armgord/Exocortex/hardware/m1_discrete_afe.kicad_sch

## KiCad design hardware/m1_discrete_afe.kicad_sch (2026-11-02)

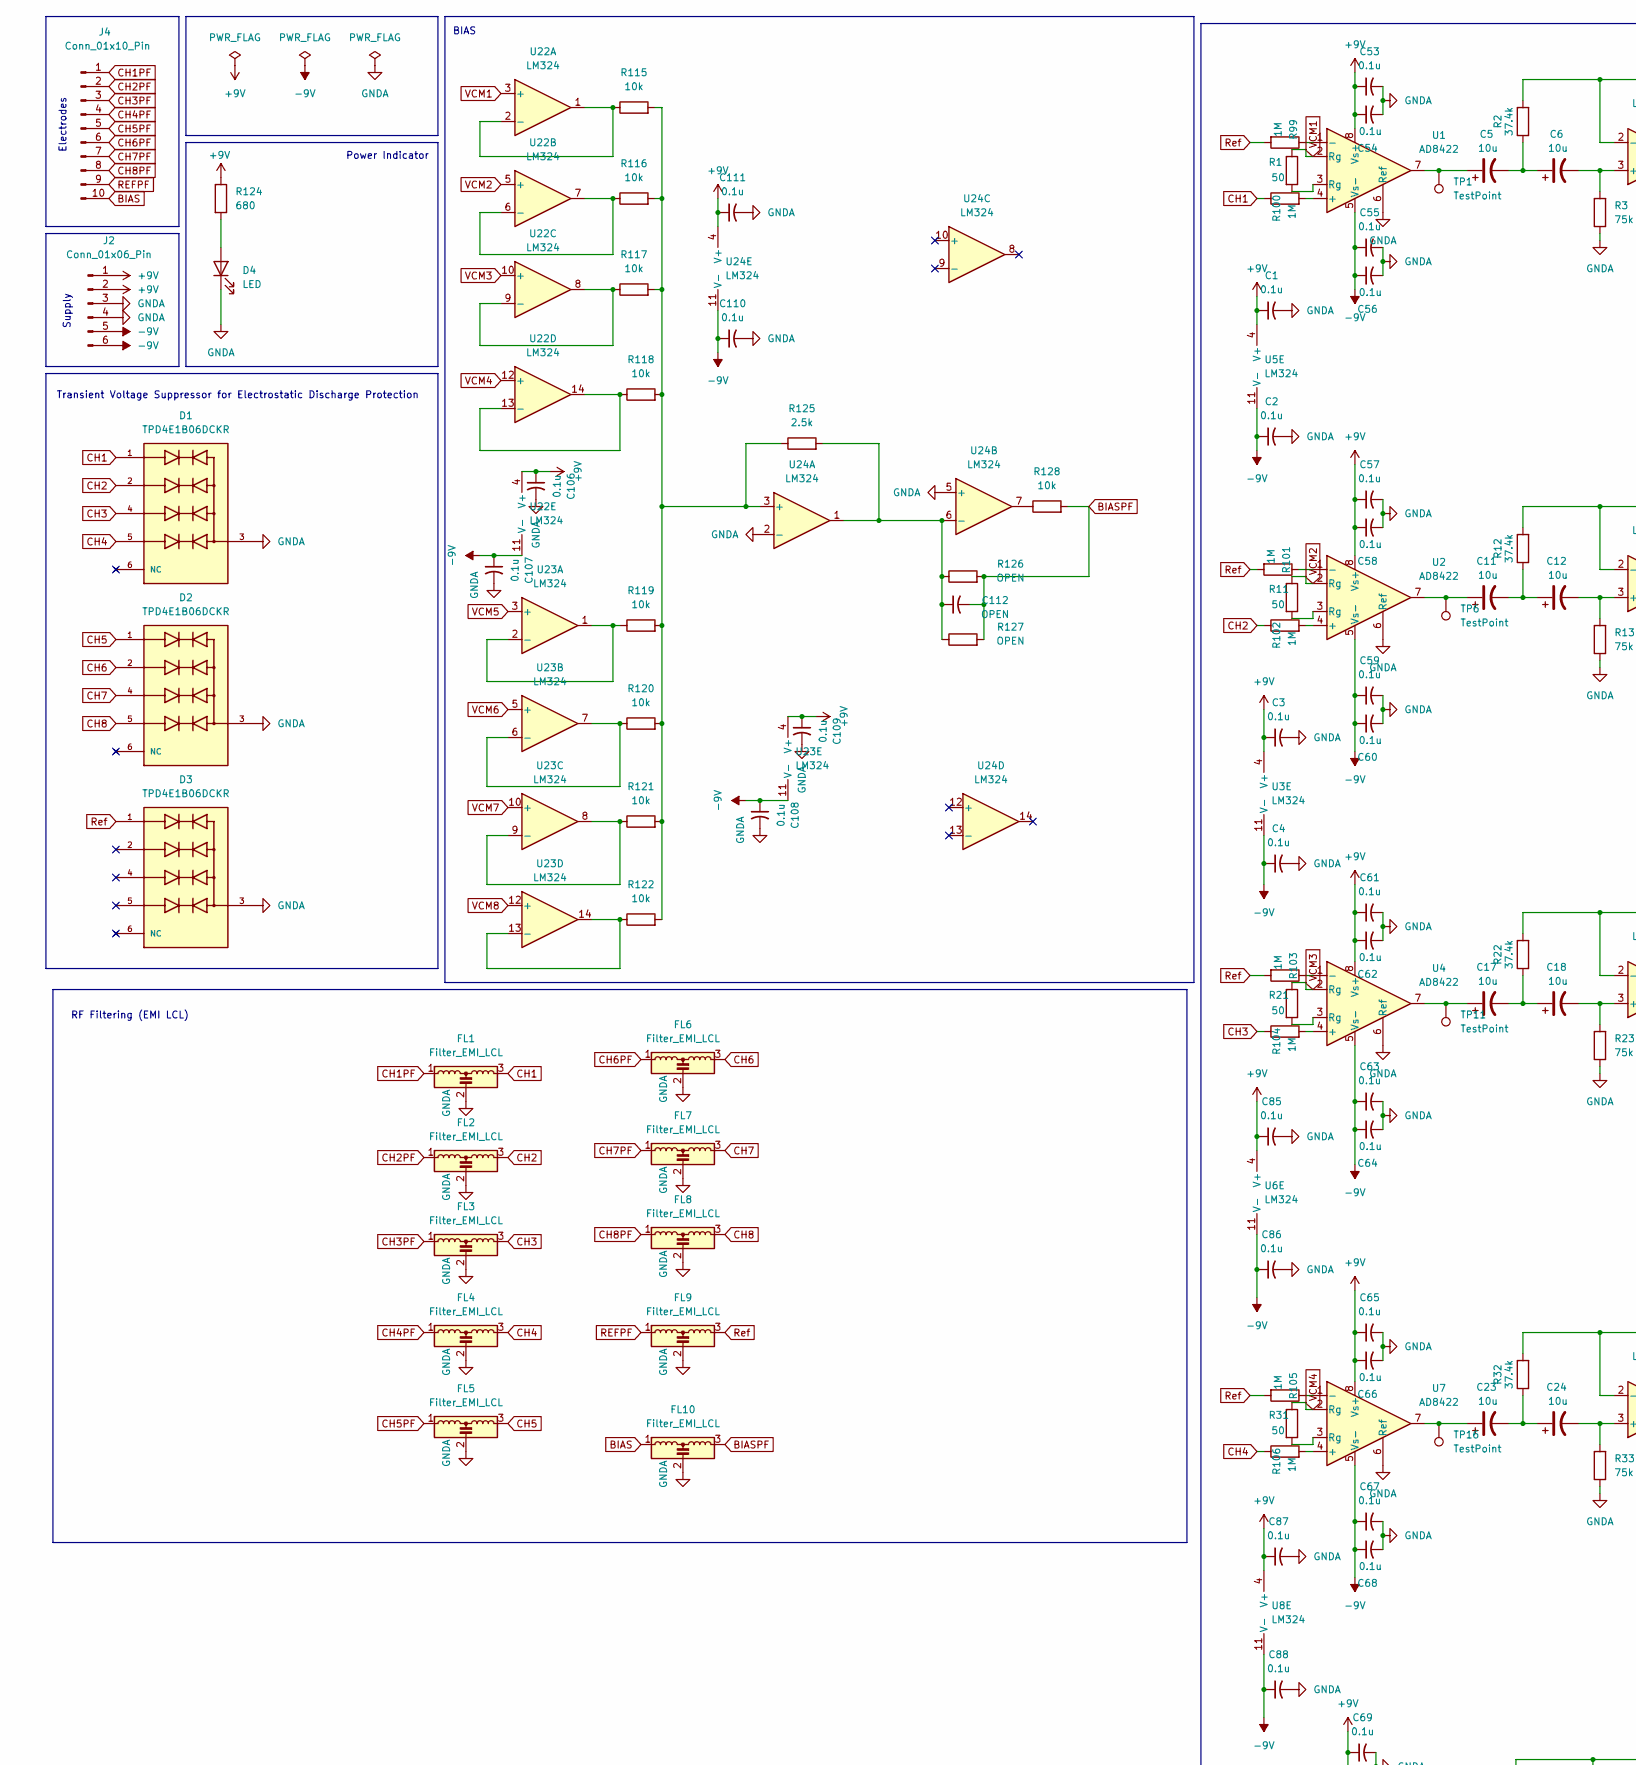
[picture p4: schematic m1_discrete_afe.kicad_sch, part in row 1, column 1]

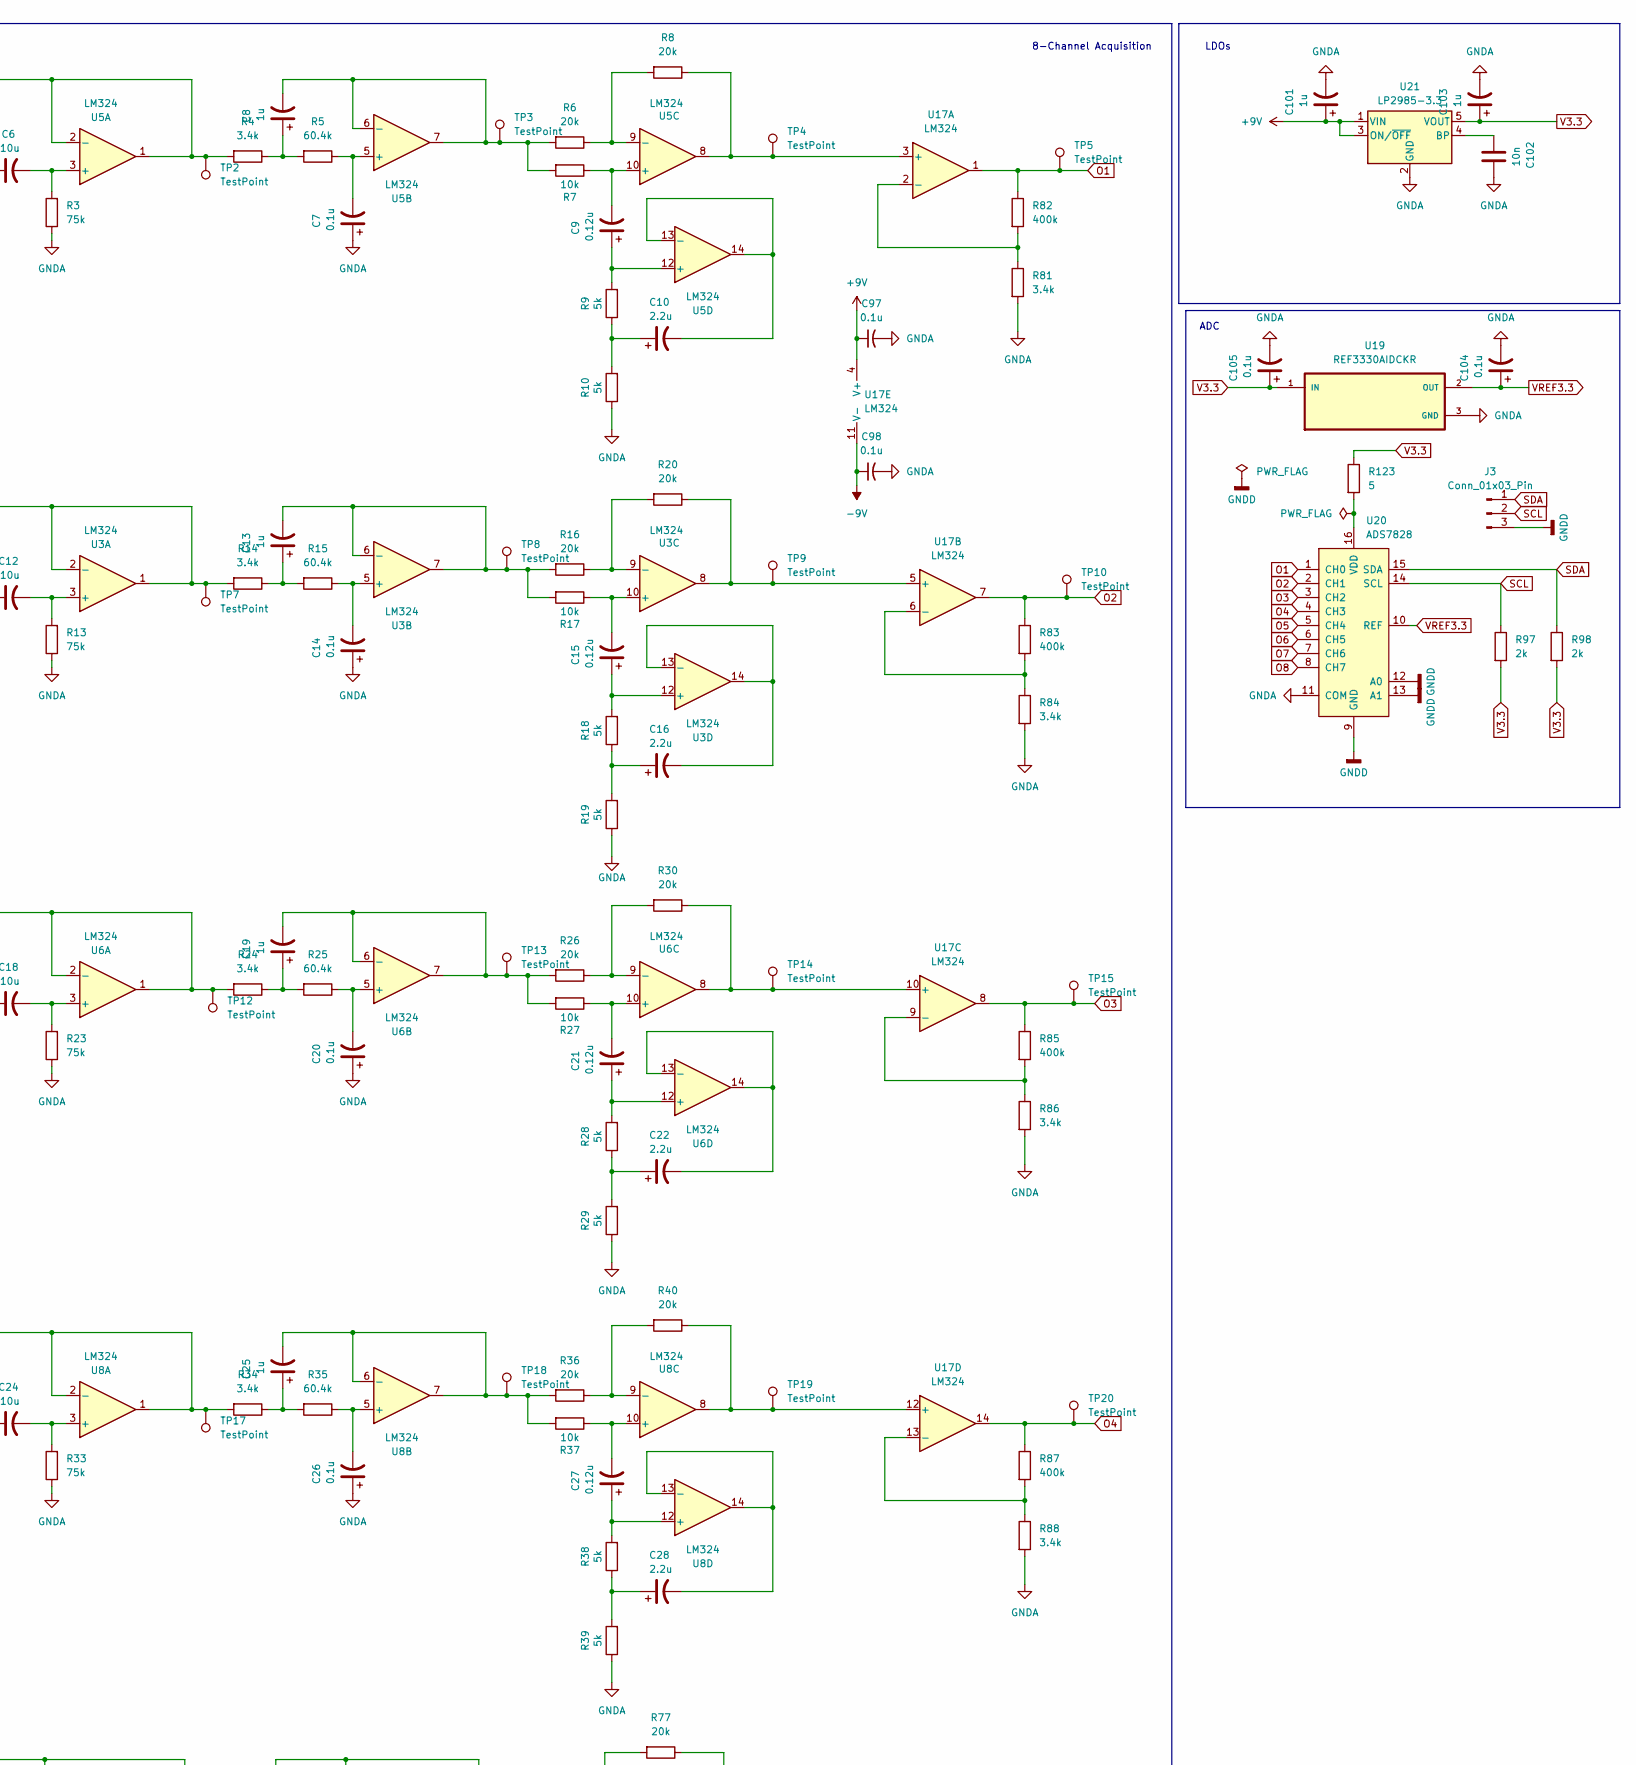
[picture p5: schematic m1_discrete_afe.kicad_sch, part in row 1, column 2]

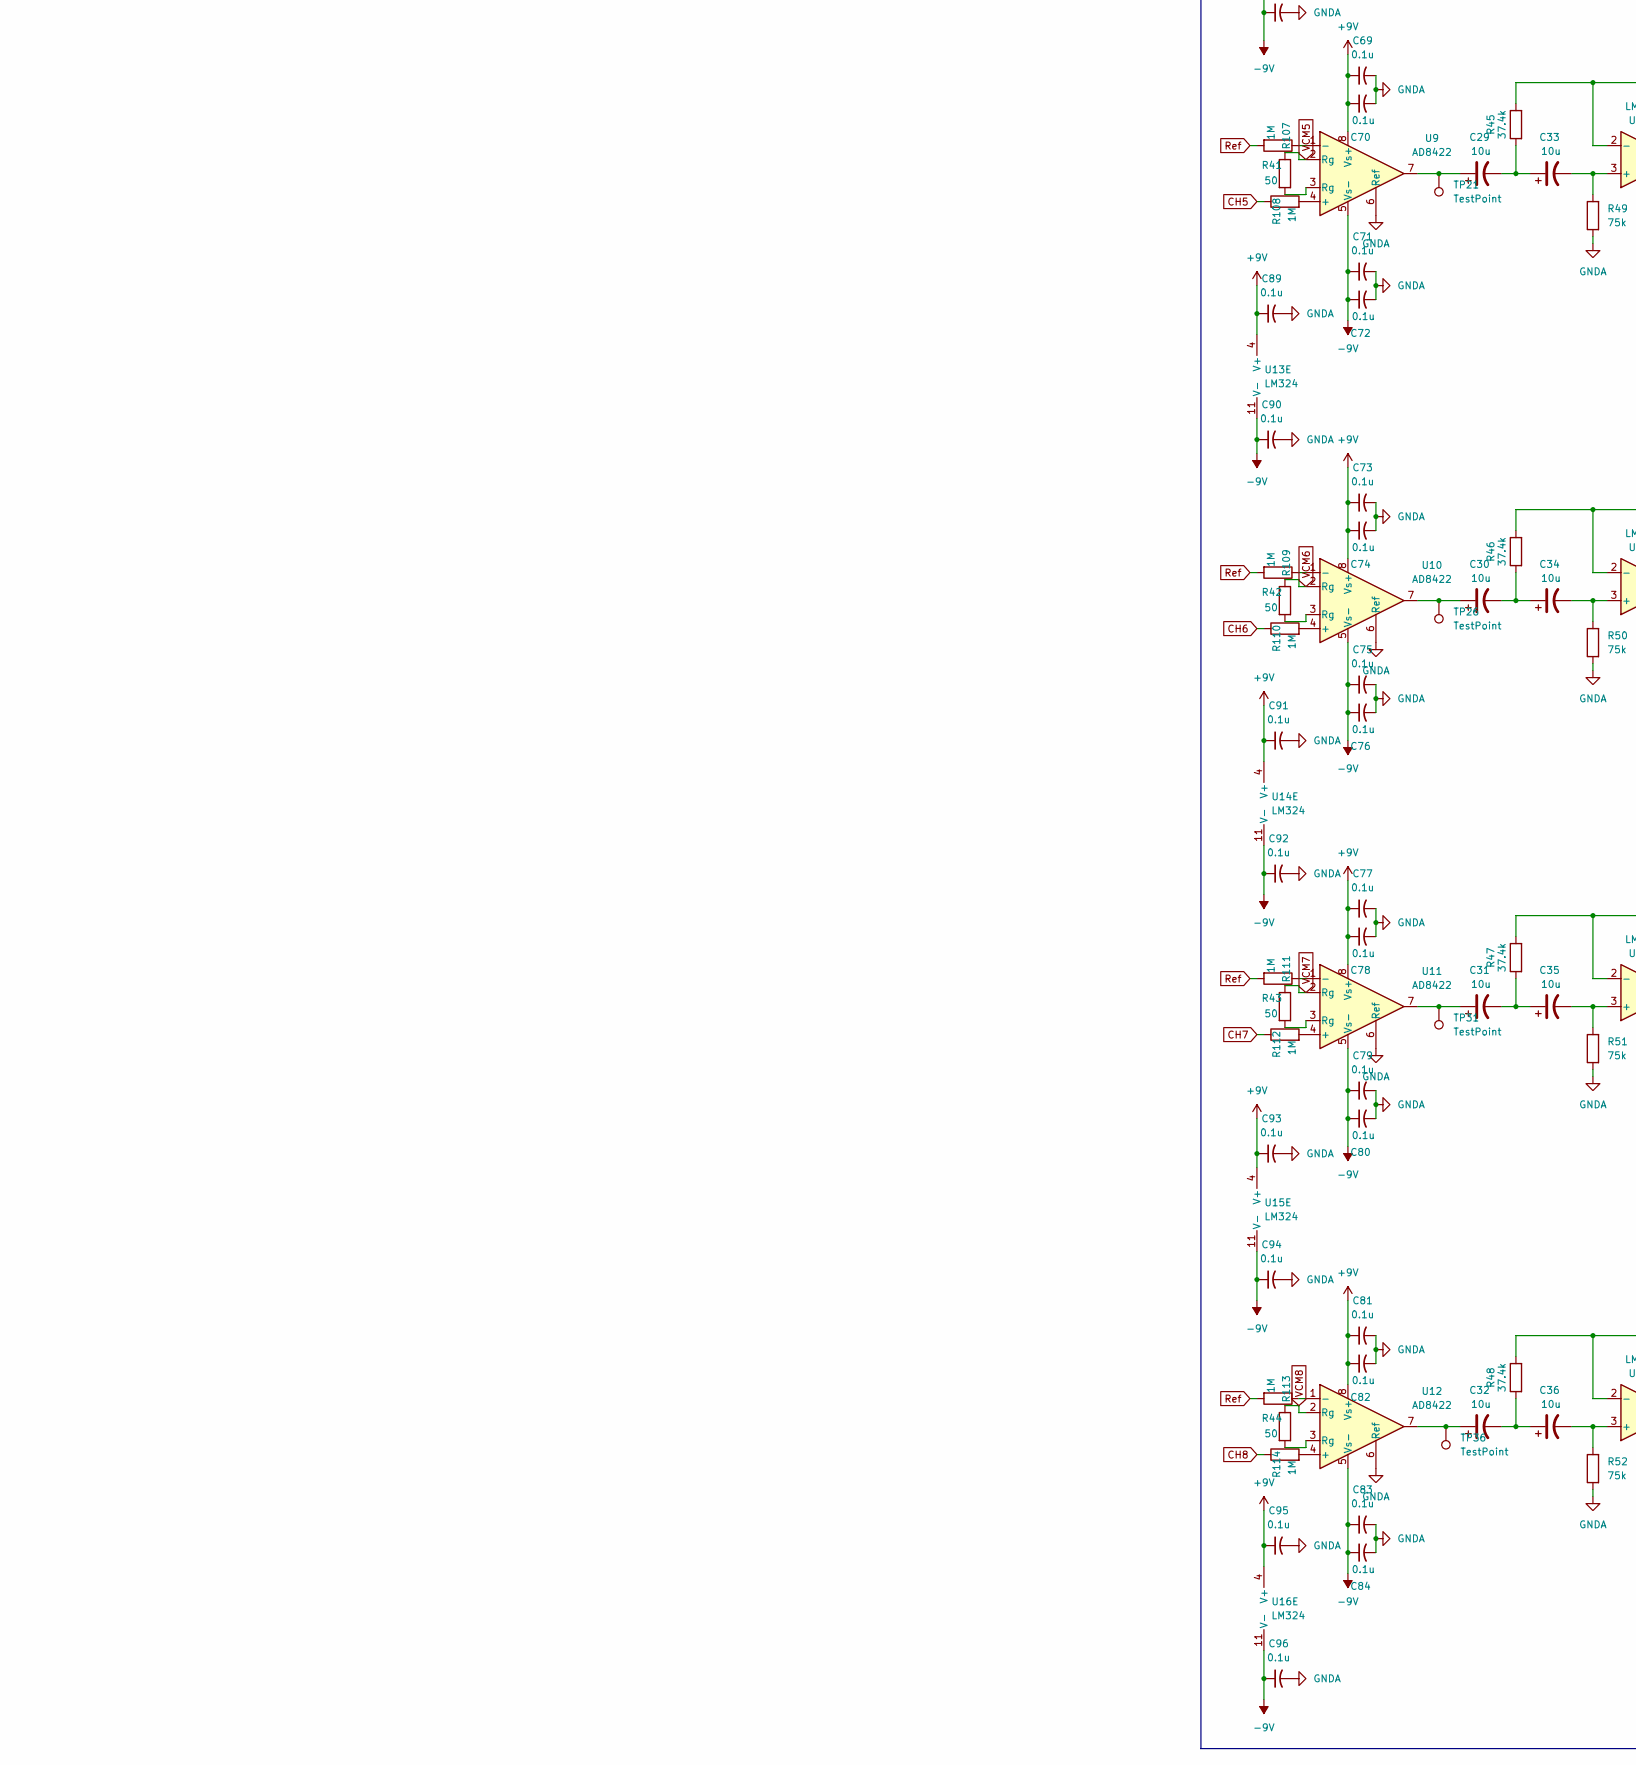
[picture p6: schematic m1_discrete_afe.kicad_sch, part in row 2, column 1]

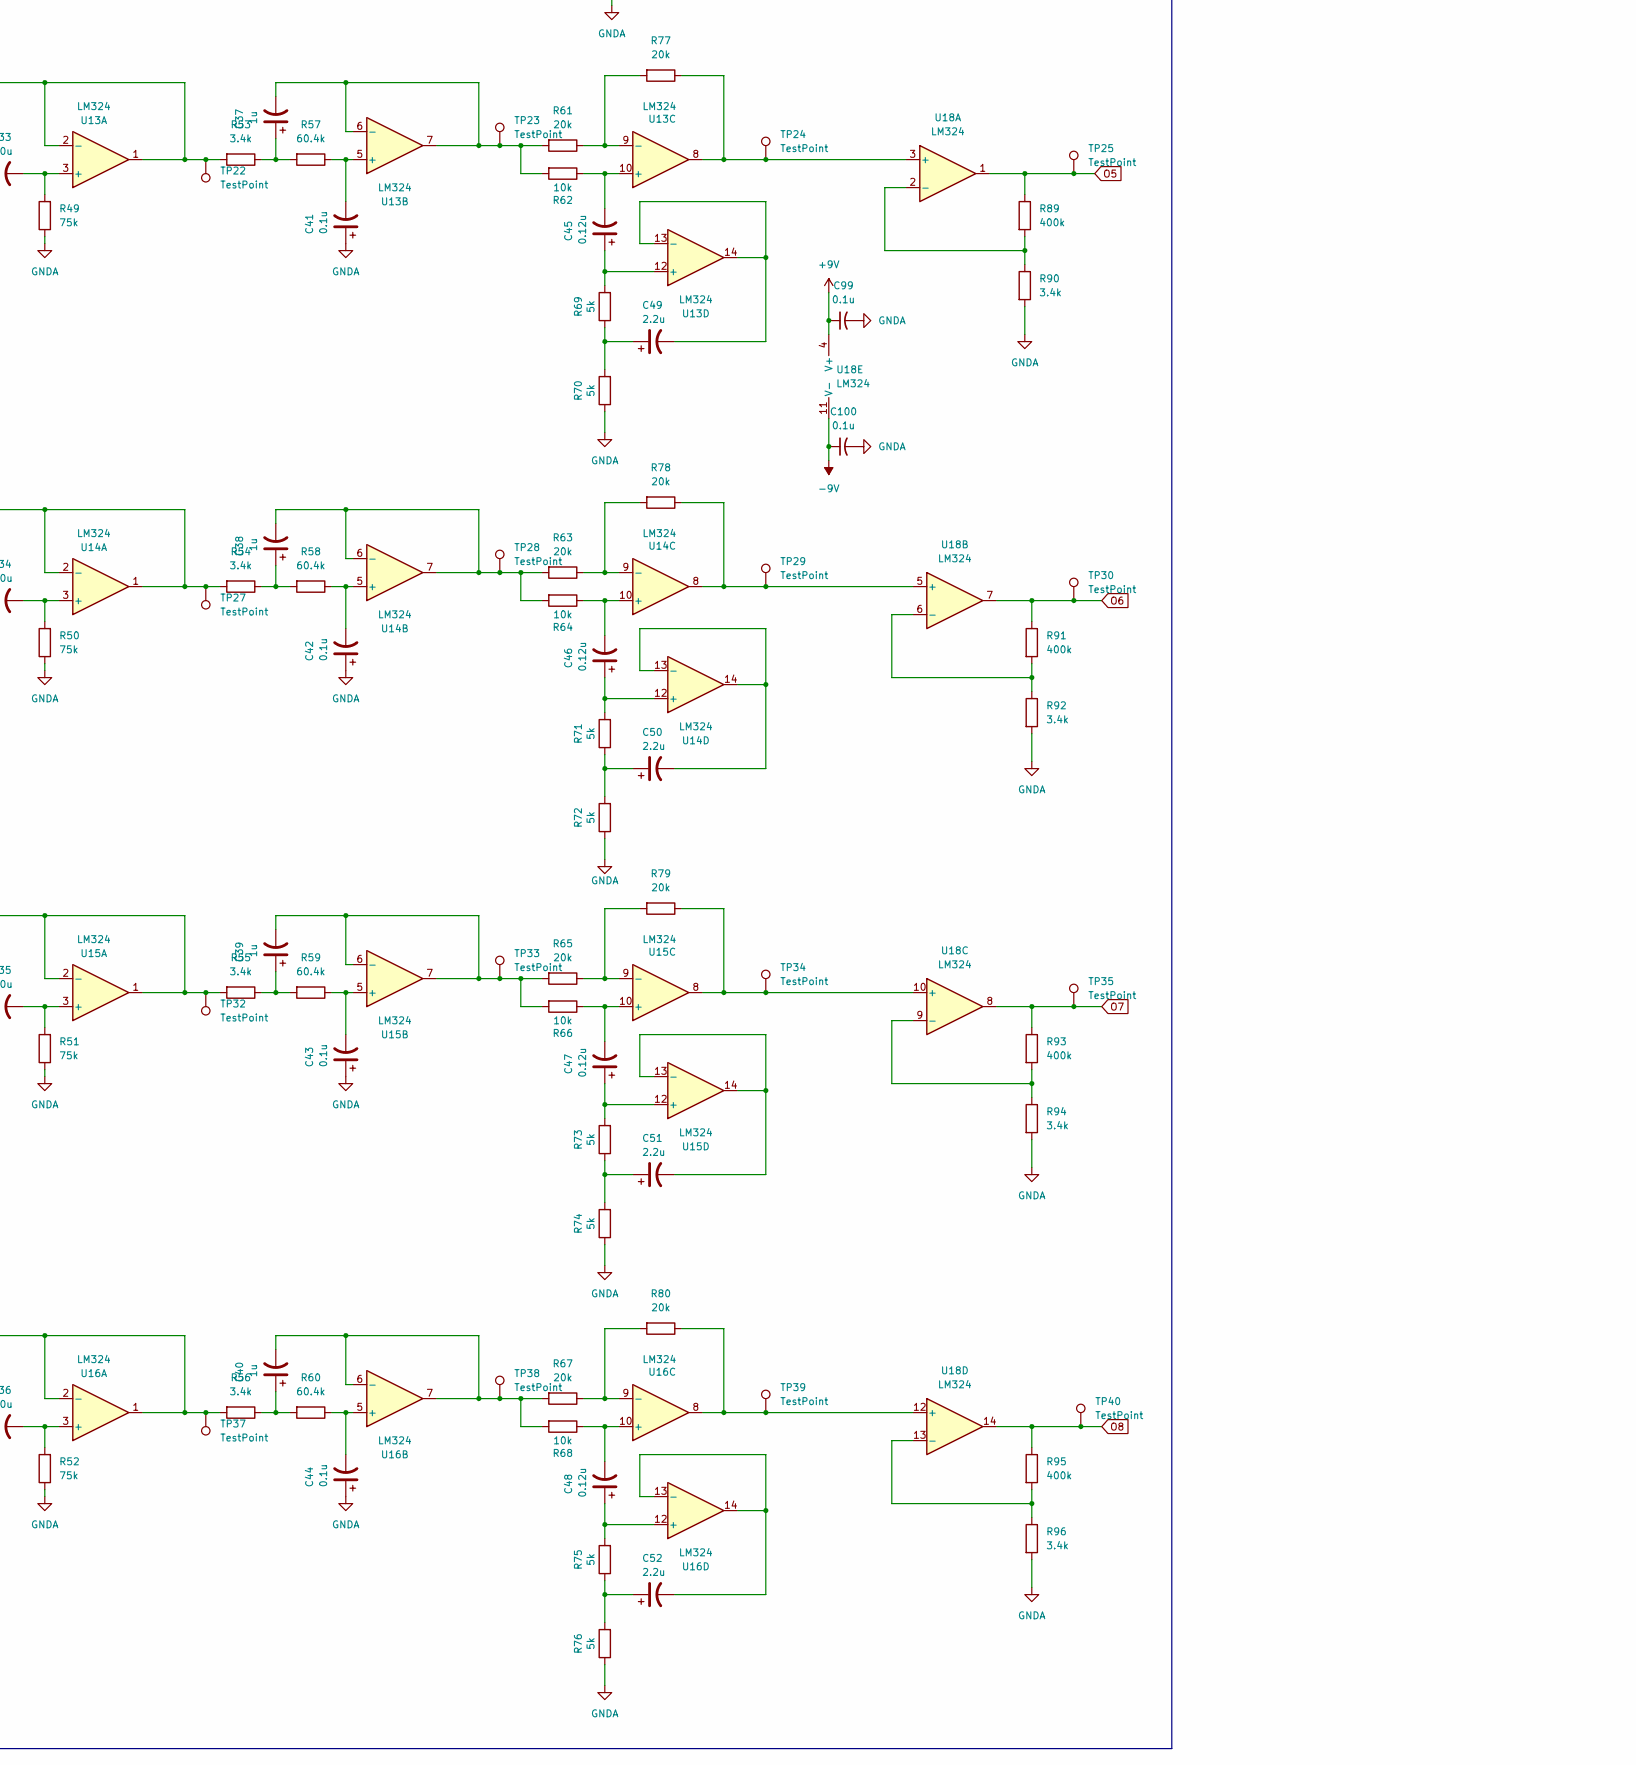
[picture p7: schematic m1_discrete_afe.kicad_sch, part in row 2, column 2]

Parts:
C1, C2, C3, C4, C7, C14, C20, C26, C41, C42, C43, C44, C53, C54, C55, C56, C57, C58, C59, C60, C61, C62, C63, C64, C65, C66, C67, C68, C69, C70, C71, C72, C73, C74, C75, C76, C77, C78, C79, C80, C81, C82, C83, C84, C85, C86, C87, C88, C89, C90, C91, C92, C93, C94, C95, C96, C97, C98, C99, C100, C106, C107, C108, C109, C110, C111: 0.1u; C_0402_1005Metric
C5, C6, C11, C12, C17, C18, C23, C24, C29, C30, C31, C32, C33, C34, C35, C36: 10u; C_0603_1608Metric
C8, C13, C19, C25, C37, C38, C39, C40, C101, C103: 1u; C_0603_1608Metric
C9, C15, C21, C27, C45, C46, C47, C48: 0.12u; C_0402_1005Metric
C10, C16, C22, C28, C49, C50, C51, C52: 2.2u; C_0603_1608Metric
C102: 10n; C_0603_1608Metric
C104, C105: 0.1u; C_0603_1608Metric
C112: OPEN; C_0402_1005Metric
D1, D2, D3: TPD4E1B06DCKR; TVS_TPD4E1B06DCKR; PARTREV C
D4: LED; LED_0402_1005Metric
FL1, FL2, FL3, FL4, FL5, FL6, FL7, FL8, FL9, FL10: Filter_EMI_LCL; Resonator_SMD-3Pin_7.2x3.0mm_HandSoldering
J2: Conn_01x06_Pin; PinHeader_1x06_P2.54mm_Vertical
J3: Conn_01x03_Pin; PinHeader_1x03_P2.54mm_Vertical
J4: Conn_01x10_Pin; PinHeader_1x10_P2.54mm_Horizontal
R1, R11, R21, R31, R41, R42, R43, R44: 50; R_0603_1608Metric
R2, R12, R22, R32, R45, R46, R47, R48: 37.4k; R_0603_1608Metric
R3, R13, R23, R33, R49, R50, R51, R52: 75k; R_0603_1608Metric
R4, R14, R24, R34, R53, R54, R55, R56, R81, R84, R86, R88, R90, R92, R94, R96: 3.4k; R_0603_1608Metric
R5, R15, R25, R35, R57, R58, R59, R60: 60.4k; R_0603_1608Metric
R6, R8, R16, R20, R26, R30, R36, R40, R61, R63, R65, R67, R77, R78, R79, R80: 20k; R_0603_1608Metric
R7, R17, R27, R37, R62, R64, R66, R68, R115, R116, R117, R118, R119, R120, R121, R122, R128: 10k; R_0603_1608Metric
R9, R10, R18, R19, R28, R29, R38, R39, R69, R70, R71, R72, R73, R74, R75, R76: 5k; R_0603_1608Metric
R82, R83, R85, R87, R89, R91, R93, R95: 400k; R_0603_1608Metric
R97, R98: 2k; R_0603_1608Metric
R99, R100, R101, R102, R103, R104, R105, R106, R107, R108, R109, R110, R111, R112, R113, R114: 1M; R_0603_1608Metric
R123: 5; R_0603_1608Metric
R124: 680; R_0603_1608Metric
R125: 2.5k; R_0603_1608Metric
R126, R127: OPEN; R_0603_1608Metric
TP1, TP2, TP3, TP4, TP5, TP6, TP7, TP8, TP9, TP10, TP11, TP12, TP13, TP14, TP15, TP16, TP17, TP18, TP19, TP20, TP21, TP22, TP23, TP24, TP25, TP26, TP27, TP28, TP29, TP30, TP31, TP32, TP33, TP34, TP35, TP36, TP37, TP38, TP39, TP40: TestPoint; TestPoint_THTPad_D1.0mm_Drill0.5mm
U1, U2, U4, U7, U9, U10, U11, U12: AD8422; SOIC-8_3.9x4.9mm_P1.27mm
U3, U5, U6, U8, U13, U14, U15, U16, U17, U18, U22, U23, U24: LM324; SOIC-14_3.9x8.7mm_P1.27mm
U19: REF3330AIDCKR; SOT65P210X110-3N; DIGI-KEY_PART_NUMBER 296-22636-1-ND
U20: ADS7828; TSSOP-16_4.4x5mm_P0.65mm
U21: LP2985-3.3; SOT-23-5

Connections:
+9V: C1.1, C3.1, C53.1, C54.1, C57.1, C58.1, C61.1, C62.1, C65.1, C66.1, C69.1, C70.1, C73.1, C74.1, C77.1, C78.1, C81.1, C82.1, C85.1, C87.1, C89.1, C91.1, C93.1, C95.1, C97.1, C99.1, C101.1, C106.1, C109.1, C111.1, J2.1, J2.2, R124.1, U1.8 (Vs+), U2.8 (Vs+), U3.4 (V+), U4.8 (Vs+), U5.4 (V+), U6.4 (V+), U7.8 (Vs+), U8.4 (V+), U9.8 (Vs+), U10.8 (Vs+), U11.8 (Vs+), U12.8 (Vs+), U13.4 (V+), U14.4 (V+), U15.4 (V+), U16.4 (V+), U17.4 (V+), U18.4 (V+), U21.1 (VIN), U21.3 (ON/~OFF), U22.4 (V+), U23.4 (V+), U24.4 (V+)
-9V: C2.1, C4.1, C55.1, C56.1, C59.1, C60.1, C63.1, C64.1, C67.1, C68.1, C71.1, C72.1, C75.1, C76.1, C79.1, C80.1, C83.1, C84.1, C86.1, C88.1, C90.1, C92.1, C94.1, C96.1, C98.1, C100.1, C107.1, C108.1, C110.1, J2.5, J2.6, U1.5 (Vs-), U2.5 (Vs-), U3.11 (V-), U4.5 (Vs-), U5.11 (V-), U6.11 (V-), U7.5 (Vs-), U8.11 (V-), U9.5 (Vs-), U10.5 (Vs-), U11.5 (Vs-), U12.5 (Vs-), U13.11 (V-), U14.11 (V-), U15.11 (V-), U16.11 (V-), U17.11 (V-), U18.11 (V-), U22.11 (V-), U23.11 (V-), U24.11 (V-)
BIAS: FL10.1, J4.10
BIASPF: C112.2, FL10.3, R126.2, R127.2, R128.2
CH1: D1.1, FL1.3, R100.1
CH1PF: FL1.1, J4.1
CH2: D1.2, FL2.3, R102.1
CH2PF: FL2.1, J4.2
CH3: D1.4, FL3.3, R104.1
CH3PF: FL3.1, J4.3
CH4: D1.5, FL4.3, R106.1
CH4PF: FL4.1, J4.4
CH5: D2.1, FL5.3, R108.1
CH5PF: FL5.1, J4.5
CH6: D2.2, FL6.3, R110.1
CH6PF: FL6.1, J4.6
CH7: D2.4, FL7.3, R112.1
CH7PF: FL7.1, J4.7
CH8: D2.5, FL8.3, R114.1
CH8PF: FL8.1, J4.8
GNDA: C1.2, C2.2, C3.2, C4.2, C7.1, C14.1, C20.1, C26.1, C41.1, C42.1, C43.1, C44.1, C53.2, C54.2, C55.2, C56.2, C57.2, C58.2, C59.2, C60.2, C61.2, C62.2, C63.2, C64.2, C65.2, C66.2, C67.2, C68.2, C69.2, C70.2, C71.2, C72.2, C73.2, C74.2, C75.2, C76.2, C77.2, C78.2, C79.2, C80.2, C81.2, C82.2, C83.2, C84.2, C85.2, C86.2, C87.2, C88.2, C89.2, C90.2, C91.2, C92.2, C93.2, C94.2, C95.2, C96.2, C97.2, C98.2, C99.2, C100.2, C101.2, C102.2, C103.2, C104.2, C105.2, C106.2, C107.2, C108.2, C109.2, C110.2, C111.2, D1.3, D2.3, D3.3, D4.1 (K), FL1.2, FL2.2, FL3.2, FL4.2, FL5.2, FL6.2, FL7.2, FL8.2, FL9.2, FL10.2, J2.3, J2.4, R3.1, R10.1, R13.1, R19.1, R23.1, R29.1, R33.1, R39.1, R49.1, R50.1, R51.1, R52.1, R70.1, R72.1, R74.1, R76.1, R81.2, R84.2, R86.2, R88.2, R90.2, R92.2, R94.2, R96.2, U1.6 (Ref), U2.6 (Ref), U4.6 (Ref), U7.6 (Ref), U9.6 (Ref), U10.6 (Ref), U11.6 (Ref), U12.6 (Ref), U19.3 (GND), U20.11 (COM), U21.2 (GND), U24.2 (-), U24.5 (+)
GNDD: J3.3, U20.9 (GND), U20.12 (A0), U20.13 (A1)
unnamed: C5.1, TP1.1, U1.7
unnamed: C5.2, C6.1, R2.1
unnamed: C6.2, R3.2, U5.3 (+)
unnamed: C7.2, R5.1, U5.5 (+)
unnamed: C8.1, R4.1, R5.2
unnamed: C8.2, R6.2, R7.2, TP3.1, U5.6 (-), U5.7
unnamed: C9.1, R9.2, U5.12 (+)
unnamed: C9.2, R7.1, U5.10 (+)
unnamed: C10.1, R9.1, R10.2
unnamed: C10.2, U5.13 (-), U5.14
unnamed: C11.1, TP6.1, U2.7
unnamed: C11.2, C12.1, R12.1
unnamed: C12.2, R13.2, U3.3 (+)
unnamed: C13.1, R14.1, R15.2
unnamed: C13.2, R16.2, R17.2, TP8.1, U3.6 (-), U3.7
unnamed: C14.2, R15.1, U3.5 (+)
unnamed: C15.1, R18.2, U3.12 (+)
unnamed: C15.2, R17.1, U3.10 (+)
unnamed: C16.1, R18.1, R19.2
unnamed: C16.2, U3.13 (-), U3.14
unnamed: C17.1, TP11.1, U4.7
unnamed: C17.2, C18.1, R22.1
unnamed: C18.2, R23.2, U6.3 (+)
unnamed: C19.1, R24.1, R25.2
unnamed: C19.2, R26.2, R27.2, TP13.1, U6.6 (-), U6.7
unnamed: C20.2, R25.1, U6.5 (+)
unnamed: C21.1, R28.2, U6.12 (+)
unnamed: C21.2, R27.1, U6.10 (+)
unnamed: C22.1, R28.1, R29.2
unnamed: C22.2, U6.13 (-), U6.14
unnamed: C23.1, TP16.1, U7.7
unnamed: C23.2, C24.1, R32.1
unnamed: C24.2, R33.2, U8.3 (+)
unnamed: C25.1, R34.1, R35.2
unnamed: C25.2, R36.2, R37.2, TP18.1, U8.6 (-), U8.7
unnamed: C26.2, R35.1, U8.5 (+)
unnamed: C27.1, R38.2, U8.12 (+)
unnamed: C27.2, R37.1, U8.10 (+)
unnamed: C28.1, R38.1, R39.2
unnamed: C28.2, U8.13 (-), U8.14
unnamed: C29.1, TP21.1, U9.7
unnamed: C29.2, C33.1, R45.1
unnamed: C30.1, TP26.1, U10.7
unnamed: C30.2, C34.1, R46.1
unnamed: C31.1, TP31.1, U11.7
unnamed: C31.2, C35.1, R47.1
unnamed: C32.1, TP36.1, U12.7
unnamed: C32.2, C36.1, R48.1
unnamed: C33.2, R49.2, U13.3 (+)
unnamed: C34.2, R50.2, U14.3 (+)
unnamed: C35.2, R51.2, U15.3 (+)
unnamed: C36.2, R52.2, U16.3 (+)
unnamed: C37.1, R53.1, R57.2
unnamed: C37.2, R61.2, R62.2, TP23.1, U13.6 (-), U13.7
unnamed: C38.1, R54.1, R58.2
unnamed: C38.2, R63.2, R64.2, TP28.1, U14.6 (-), U14.7
unnamed: C39.1, R55.1, R59.2
unnamed: C39.2, R65.2, R66.2, TP33.1, U15.6 (-), U15.7
unnamed: C40.1, R56.1, R60.2
unnamed: C40.2, R67.2, R68.2, TP38.1, U16.6 (-), U16.7
unnamed: C41.2, R57.1, U13.5 (+)
unnamed: C42.2, R58.1, U14.5 (+)
unnamed: C43.2, R59.1, U15.5 (+)
unnamed: C44.2, R60.1, U16.5 (+)
unnamed: C45.1, R69.2, U13.12 (+)
unnamed: C45.2, R62.1, U13.10 (+)
unnamed: C46.1, R71.2, U14.12 (+)
unnamed: C46.2, R64.1, U14.10 (+)
unnamed: C47.1, R73.2, U15.12 (+)
unnamed: C47.2, R66.1, U15.10 (+)
unnamed: C48.1, R75.2, U16.12 (+)
unnamed: C48.2, R68.1, U16.10 (+)
unnamed: C49.1, R69.1, R70.2
unnamed: C49.2, U13.13 (-), U13.14
unnamed: C50.1, R71.1, R72.2
unnamed: C50.2, U14.13 (-), U14.14
unnamed: C51.1, R73.1, R74.2
unnamed: C51.2, U15.13 (-), U15.14
unnamed: C52.1, R75.1, R76.2
unnamed: C52.2, U16.13 (-), U16.14
unnamed: C102.1, U21.4 (BP)
unnamed: C112.1, R125.2, R126.1, R127.1, U24.1, U24.6 (-)
unnamed: D4.2 (A), R124.2
unnamed: R1.2, U1.3 (Rg)
unnamed: R2.2, R4.2, TP2.1, U5.1, U5.2 (-)
unnamed: R6.1, R8.2, U5.9 (-)
unnamed: R8.1, TP4.1, U5.8, U17.3 (+)
unnamed: R11.2, U2.3 (Rg)
unnamed: R12.2, R14.2, TP7.1, U3.1, U3.2 (-)
unnamed: R16.1, R20.2, U3.9 (-)
unnamed: R20.1, TP9.1, U3.8, U17.5 (+)
unnamed: R21.2, U4.3 (Rg)
unnamed: R22.2, R24.2, TP12.1, U6.1, U6.2 (-)
unnamed: R26.1, R30.2, U6.9 (-)
unnamed: R30.1, TP14.1, U6.8, U17.10 (+)
unnamed: R31.2, U7.3 (Rg)
unnamed: R32.2, R34.2, TP17.1, U8.1, U8.2 (-)
unnamed: R36.1, R40.2, U8.9 (-)
unnamed: R40.1, TP19.1, U8.8, U17.12 (+)
unnamed: R41.2, U9.3 (Rg)
unnamed: R42.2, U10.3 (Rg)
unnamed: R43.2, U11.3 (Rg)
unnamed: R44.2, U12.3 (Rg)
unnamed: R45.2, R53.2, TP22.1, U13.1, U13.2 (-)
unnamed: R46.2, R54.2, TP27.1, U14.1, U14.2 (-)
unnamed: R47.2, R55.2, TP32.1, U15.1, U15.2 (-)
unnamed: R48.2, R56.2, TP37.1, U16.1, U16.2 (-)
unnamed: R61.1, R77.2, U13.9 (-)
unnamed: R63.1, R78.2, U14.9 (-)
unnamed: R65.1, R79.2, U15.9 (-)
unnamed: R67.1, R80.2, U16.9 (-)
unnamed: R77.1, TP24.1, U13.8, U18.3 (+)
unnamed: R78.1, TP29.1, U14.8, U18.5 (+)
unnamed: R79.1, TP34.1, U15.8, U18.10 (+)
unnamed: R80.1, TP39.1, U16.8, U18.12 (+)
unnamed: R81.1, R82.2, U17.2 (-)
unnamed: R83.2, R84.1, U17.6 (-)
unnamed: R85.2, R86.1, U17.9 (-)
unnamed: R87.2, R88.1, U17.13 (-)
unnamed: R89.2, R90.1, U18.2 (-)
unnamed: R91.2, R92.1, U18.6 (-)
unnamed: R93.2, R94.1, U18.9 (-)
unnamed: R95.2, R96.1, U18.13 (-)
unnamed: R99.1, U1.1 (-)
unnamed: R100.2, U1.4 (+)
unnamed: R101.1, U2.1 (-)
unnamed: R102.2, U2.4 (+)
unnamed: R103.1, U4.1 (-)
unnamed: R104.2, U4.4 (+)
unnamed: R105.1, U7.1 (-)
unnamed: R106.2, U7.4 (+)
unnamed: R107.1, U9.1 (-)
unnamed: R108.2, U9.4 (+)
unnamed: R109.1, U10.1 (-)
unnamed: R110.2, U10.4 (+)
unnamed: R111.1, U11.1 (-)
unnamed: R112.2, U11.4 (+)
unnamed: R113.1, U12.1 (-)
unnamed: R114.2, U12.4 (+)
unnamed: R115.1, U22.1, U22.2 (-)
unnamed: R115.2, R116.2, R117.2, R118.2, R119.2, R120.2, R121.2, R122.2, R125.1, U24.3 (+)
unnamed: R116.1, U22.6 (-), U22.7
unnamed: R117.1, U22.8, U22.9 (-)
unnamed: R118.1, U22.13 (-), U22.14
unnamed: R119.1, U23.1, U23.2 (-)
unnamed: R120.1, U23.6 (-), U23.7
unnamed: R121.1, U23.8, U23.9 (-)
unnamed: R122.1, U23.13 (-), U23.14
unnamed: R123.2, U20.16 (VDD)
unnamed: R128.1, U24.7
O1: R82.1, TP5.1, U17.1, U20.1 (CH0)
O2: R83.1, TP10.1, U17.7, U20.2 (CH1)
O3: R85.1, TP15.1, U17.8, U20.3 (CH2)
O4: R87.1, TP20.1, U17.14, U20.4 (CH3)
O5: R89.1, TP25.1, U18.1, U20.5 (CH4)
O6: R91.1, TP30.1, U18.7, U20.6 (CH5)
O7: R93.1, TP35.1, U18.8, U20.7 (CH6)
O8: R95.1, TP40.1, U18.14, U20.8 (CH7)
REFPF: FL9.1, J4.9
Ref: D3.1, FL9.3, R99.2, R101.2, R103.2, R105.2, R107.2, R109.2, R111.2, R113.2
SCL: J3.2, R97.1, U20.14 (SCL)
SDA: J3.1, R98.1, U20.15 (SDA)
V3.3: C103.1, C105.1, R97.2, R98.2, R123.1, U19.1 (IN), U21.5 (VOUT)
VCM1: R1.1, U1.2 (Rg), U22.3 (+)
VCM2: R11.1, U2.2 (Rg), U22.5 (+)
VCM3: R21.1, U4.2 (Rg), U22.10 (+)
VCM4: R31.1, U7.2 (Rg), U22.12 (+)
VCM5: R41.1, U9.2 (Rg), U23.3 (+)
VCM6: R42.1, U10.2 (Rg), U23.5 (+)
VCM7: R43.1, U11.2 (Rg), U23.10 (+)
VCM8: R44.1, U12.2 (Rg), U23.12 (+)
VREF3.3: C104.1, U19.2 (OUT), U20.10 (REF)

Notes on the sheet:
BIAS
Transient Voltage Suppressor for Electrostatic Discharge Protection
RF Filtering (EMI LCL)
Electrodes
8-Channel Acquisition
Supply
ADC
LDOs
Power Indicator
