armgord/Exocortex/hardware/m2_ads1299.kicad_sch

## KiCad design hardware/m2_ads1299.kicad_sch (2026-02-12)

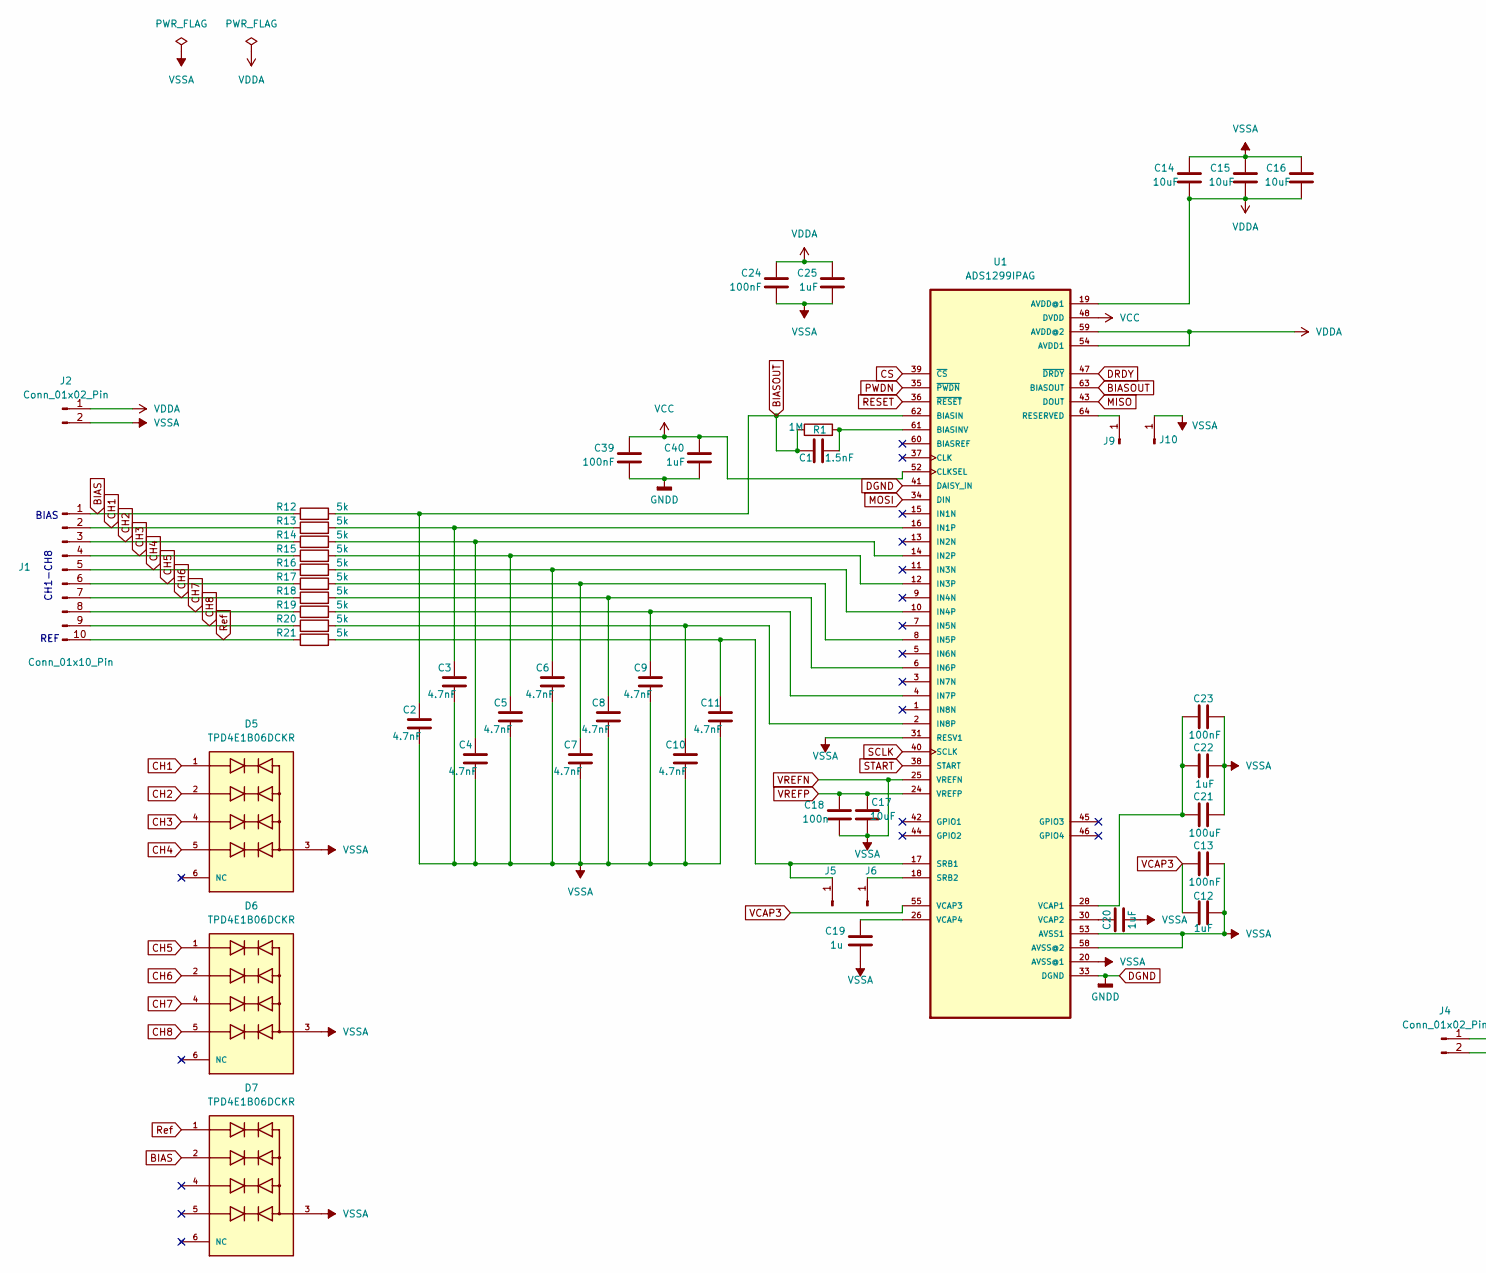
[picture p8: schematic m2_ads1299.kicad_sch, part in row 1, column 1]

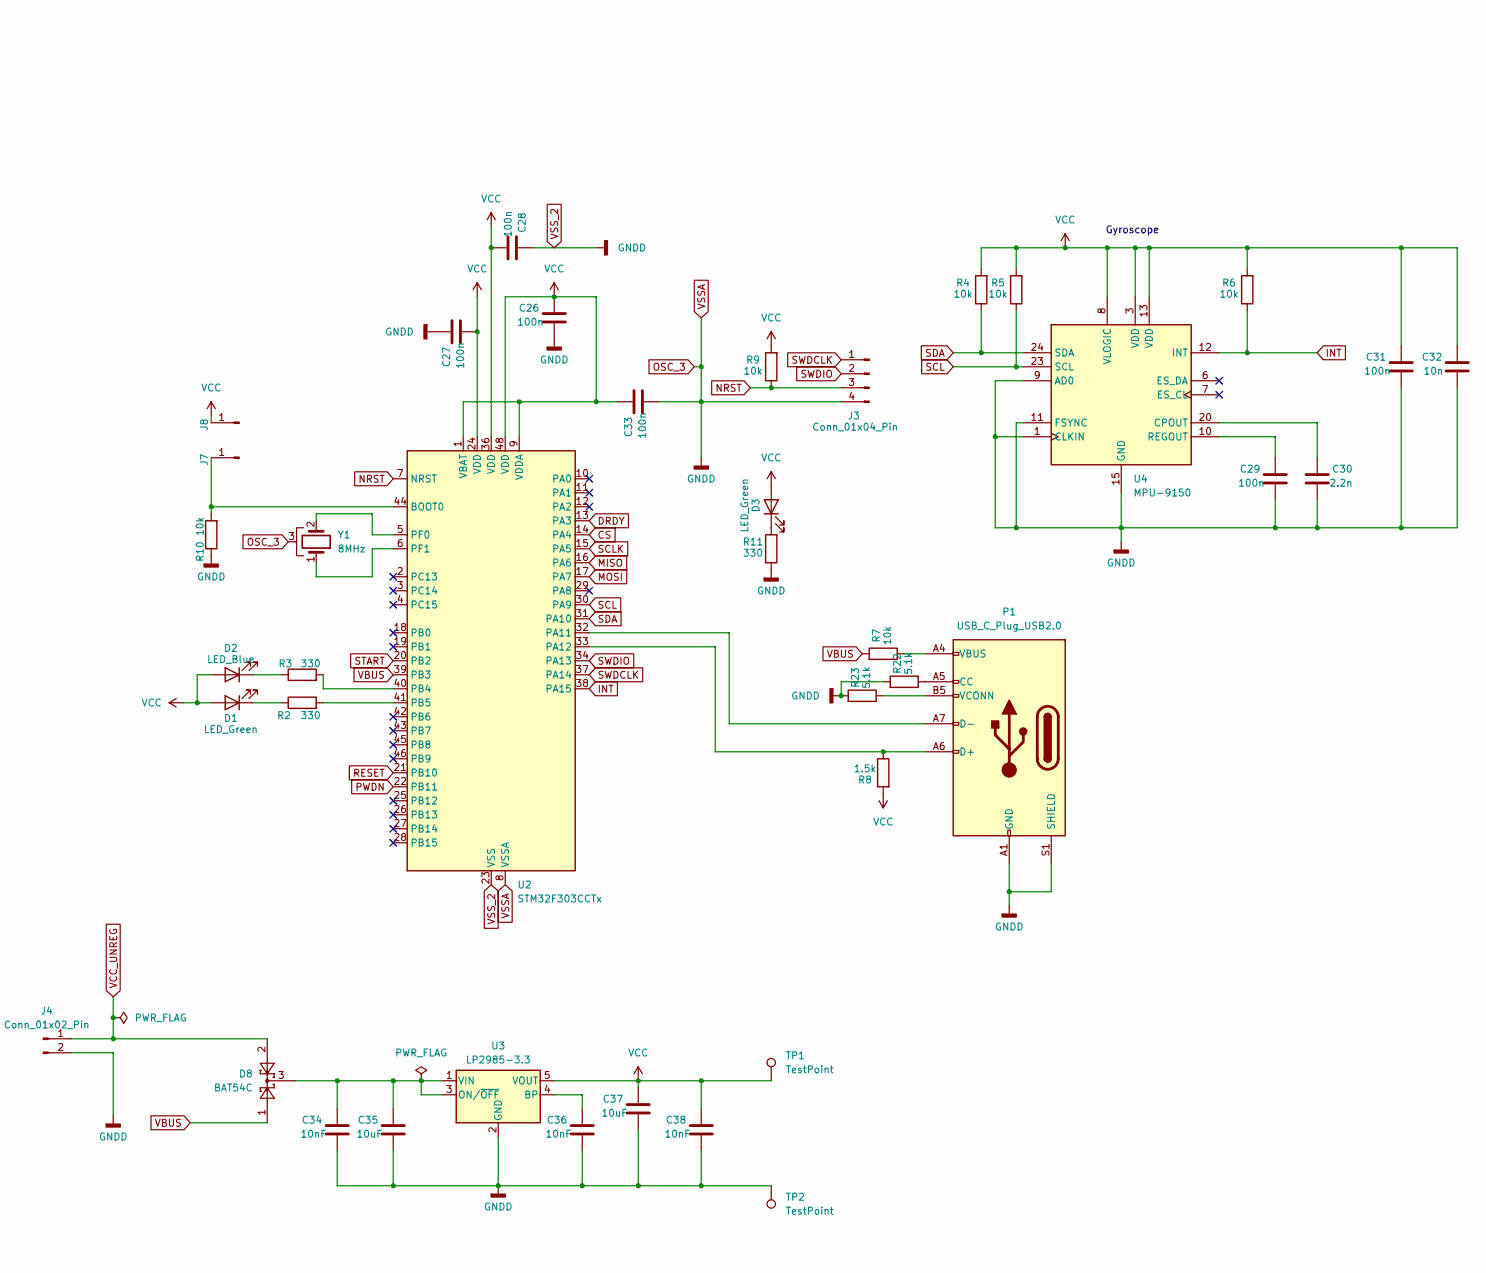
[picture p9: schematic m2_ads1299.kicad_sch, part in row 1, column 2]

Parts:
C1: 1.5nF; C_0603_1608Metric_Pad1.08x0.95mm_HandSolder
C2, C3, C4, C5, C6, C7, C8, C9, C10, C11: 4.7nF; C_0603_1608Metric_Pad1.08x0.95mm_HandSolder
C12, C20, C22, C25, C40: 1uF; C_0603_1608Metric_Pad1.08x0.95mm_HandSolder
C13, C23, C24, C39: 100nF; C_0603_1608Metric_Pad1.08x0.95mm_HandSolder
C14, C15, C16, C17, C35, C37: 10uF; C_0603_1608Metric_Pad1.08x0.95mm_HandSolder
C18, C26, C27, C28, C29, C31, C33: 100n; C_0603_1608Metric_Pad1.08x0.95mm_HandSolder
C19: 1u; C_0603_1608Metric_Pad1.08x0.95mm_HandSolder
C21: 100uF; C_0603_1608Metric_Pad1.08x0.95mm_HandSolder
C30: 2.2n; C_0603_1608Metric_Pad1.08x0.95mm_HandSolder
C32: 10n; C_0603_1608Metric_Pad1.08x0.95mm_HandSolder
C34, C36, C38: 10nF; C_0603_1608Metric_Pad1.08x0.95mm_HandSolder
D1, D3: LED_Green; LED_0603_1608Metric_Pad1.05x0.95mm_HandSolder
D2: LED_Blue; LED_0603_1608Metric_Pad1.05x0.95mm_HandSolder
D5, D6, D7: TPD4E1B06DCKR; TVS_TPD4E1B06DCKR; PARTREV C
D8: BAT54C; SOT-23_Handsoldering
J1: Conn_01x10_Pin; PinHeader_1x10_P1.27mm_Horizontal
J2, J4: Conn_01x02_Pin; PinHeader_1x02_P1.27mm_Vertical
J3: Conn_01x04_Pin; PinHeader_1x04_P2.54mm_Vertical
J5, J6, J7, J8, J9, J10: Conn_01x01_Pin; PinHeader_1x01_P1.27mm_Vertical
P1: USB_C_Plug_USB2.0; USB_C_Plug_ShenzhenJingTuoJin_918-118A2021Y40002_Vertical
R1: 1M; R_0603_1608Metric_Pad0.98x0.95mm_HandSolder
R2, R3, R11: 330; R_0603_1608Metric_Pad0.98x0.95mm_HandSolder
R4, R5, R6, R7, R9, R10: 10k; R_0603_1608Metric_Pad0.98x0.95mm_HandSolder
R8: 1.5k; R_0603_1608Metric_Pad0.98x0.95mm_HandSolder
R12, R13, R14, R15, R16, R17, R18, R19, R20, R21: 5k; R_0603_1608Metric_Pad0.98x0.95mm_HandSolder
R22, R23: 5.1k; R_0603_1608Metric_Pad0.98x0.95mm_HandSolder
TP1, TP2: TestPoint; TestPoint_THTPad_1.5x1.5mm_Drill0.7mm
U1: ADS1299IPAG; QFP50P1200X1200X120-64N
U2: STM32F303CCTx; LQFP-48_7x7mm_P0.5mm
U3: LP2985-3.3; SOT-23-5_HandSoldering
U4: MPU-9150; InvenSense_QFN-24_4x4mm_P0.5mm
Y1: 8MHz; Crystal_SMD_FrontierElectronics_FM206

Connections:
BIAS: D7.2, J1.1, R12.1
BIASOUT: C1.1, C2.2, R1.1, R12.2, U1.62 (BIASIN), U1.63 (BIASOUT)
CH1: D5.1, J1.2, R13.1
CH2: D5.2, J1.3, R14.1
CH3: D5.4, J1.4, R15.1
CH4: D5.5, J1.5, R16.1
CH5: D6.1, J1.6, R17.1
CH6: D6.2, J1.7, R18.1
CH7: D6.4, J1.8, R19.1
CH8: D6.5, J1.9, R20.1
CS: U1.39 (~CS), U2.14 (PA4)
DGND: C26.2, C27.1, C28.1, C29.2, C30.2, C31.2, C32.2, C33.2, C34.2, C35.2, C36.2, C37.2, C38.2, C39.2, C40.2, J3.4, J4.2, P1.A1 (GND), P1.A12 (GND), P1.B1 (GND), P1.B12 (GND), P1.S1 (SHIELD), R10.1, R11.1, R22.2, R23.2, TP2.1, U1.33 (DGND), U1.41 (DAISY_IN), U1.49 (DGND), U1.51 (DGND), U2.8 (VSSA), U2.23 (VSS), U2.35 (VSS), U2.47 (VSS), U3.2 (GND), U4.1 (CLKIN), U4.9 (AD0), U4.11 (FSYNC), U4.15 (GND), U4.17 (GND), U4.18 (GND), Y1.3
DRDY: U1.47 (~DRDY), U2.13 (PA3)
INT: R6.1, U2.38 (PA15), U4.12 (INT)
MISO: U1.43 (DOUT), U2.16 (PA6)
MOSI: U1.34 (DIN), U2.17 (PA7)
NRST: J3.3, R9.1, U2.7 (NRST)
unnamed: C1.2, R1.2, U1.61 (BIASINV)
unnamed: C3.2, R13.2, U1.16 (IN1P)
unnamed: C4.2, R14.2, U1.14 (IN2P)
unnamed: C5.2, R15.2, U1.12 (IN3P)
unnamed: C6.2, R16.2, U1.10 (IN4P)
unnamed: C7.2, R17.2, U1.8 (IN5P)
unnamed: C8.2, R18.2, U1.6 (IN6P)
unnamed: C9.2, R19.2, U1.4 (IN7P)
unnamed: C10.2, R20.2, U1.2 (IN8P)
unnamed: C11.2, J5.1, R21.2, U1.17 (SRB1)
unnamed: C19.1, U1.26 (VCAP4)
unnamed: C20.1, U1.30 (VCAP2)
unnamed: C21.1, C22.1, C23.1, U1.28 (VCAP1)
unnamed: C29.1, U4.10 (REGOUT)
unnamed: C30.1, U4.20 (CPOUT)
unnamed: C34.1, C35.1, D8.3, U3.1 (VIN), U3.3 (ON/~OFF)
unnamed: C36.1, U3.4 (BP)
unnamed: D1.1 (K), R2.1
unnamed: D2.1 (K), R3.1
unnamed: D3.1 (K), R11.2
unnamed: J6.1, U1.18 (SRB2)
unnamed: J7.1, R10.2, U2.44 (BOOT0)
unnamed: J9.1, U1.64 (RESERVED)
unnamed: P1.A4 (VBUS), P1.A9 (VBUS), P1.B4 (VBUS), P1.B9 (VBUS), R7.1
unnamed: P1.A5 (CC), R22.1
unnamed: P1.A6 (D+), R8.1, U2.33 (PA12)
unnamed: P1.A7 (D-), U2.32 (PA11)
unnamed: P1.B5 (VCONN), R23.1
unnamed: R2.2, U2.41 (PB5)
unnamed: R3.2, U2.40 (PB4)
unnamed: U2.5 (PF0), Y1.2
unnamed: U2.6 (PF1), Y1.1
PWDN: U1.35 (~PWDN), U2.22 (PB11)
RESET: U1.36 (~RESET), U2.21 (PB10)
Ref: D7.1, J1.10, R21.1
SCL: R5.1, U2.30 (PA9), U4.23 (SCL)
SCLK: U1.40 (SCLK), U2.15 (PA5)
SDA: R4.1, U2.31 (PA10), U4.24 (SDA)
START: U1.38 (START), U2.20 (PB2)
SWDCLK: J3.1, U2.37 (PA14)
SWDIO: J3.2, U2.34 (PA13)
VBUS: D8.1, R7.2, U2.39 (PB3)
VCAP3: C12.1, C13.1, U1.55 (VCAP3)
VCC: C26.1, C27.2, C28.2, C31.1, C32.1, C33.1, C37.1, C38.1, C39.1, C40.1, D1.2 (A), D2.2 (A), D3.2 (A), J8.1, R4.2, R5.2, R6.2, R8.2, R9.2, TP1.1, U1.48 (DVDD), U1.50 (DVDD), U1.52 (CLKSEL), U2.1 (VBAT), U2.9 (VDDA), U2.24 (VDD), U2.36 (VDD), U2.48 (VDD), U3.5 (VOUT), U4.3 (VDD), U4.8 (VLOGIC), U4.13 (VDD)
VCC_UNREG: D8.2, J4.1
VDDA: C14.2, C15.2, C16.2, C24.1, C25.1, J2.1, U1.19 (AVDD@1), U1.21 (AVDD@1), U1.22 (AVDD@1), U1.54 (AVDD1), U1.56 (AVDD@1), U1.59 (AVDD@2)
VREFN: C2.1, C3.1, C4.1, C5.1, C6.1, C7.1, C8.1, C9.1, C10.1, C11.1, C12.2, C13.2, C14.1, C15.1, C16.1, C17.2, C18.2, C19.2, C20.2, C21.2, C22.2, C23.2, C24.2, C25.2, D5.3, D6.3, D7.3, J2.2, J10.1, U1.20 (AVSS@1), U1.23 (AVSS@1), U1.25 (VREFN), U1.31 (RESV1), U1.32 (AVSS@1), U1.53 (AVSS1), U1.57 (AVSS@1), U1.58 (AVSS@2)
VREFP: C17.1, C18.1, U1.24 (VREFP)

Notes on the sheet:
BIAS
Gyroscope
CH1-CH8
REF
